Millisman/Quectel-BG95-LPWA-Module/README.md

# Quectel-BG95-LPWA-Module
Quectel BG95 LPWA Module board with integrated GPS &amp; GSM

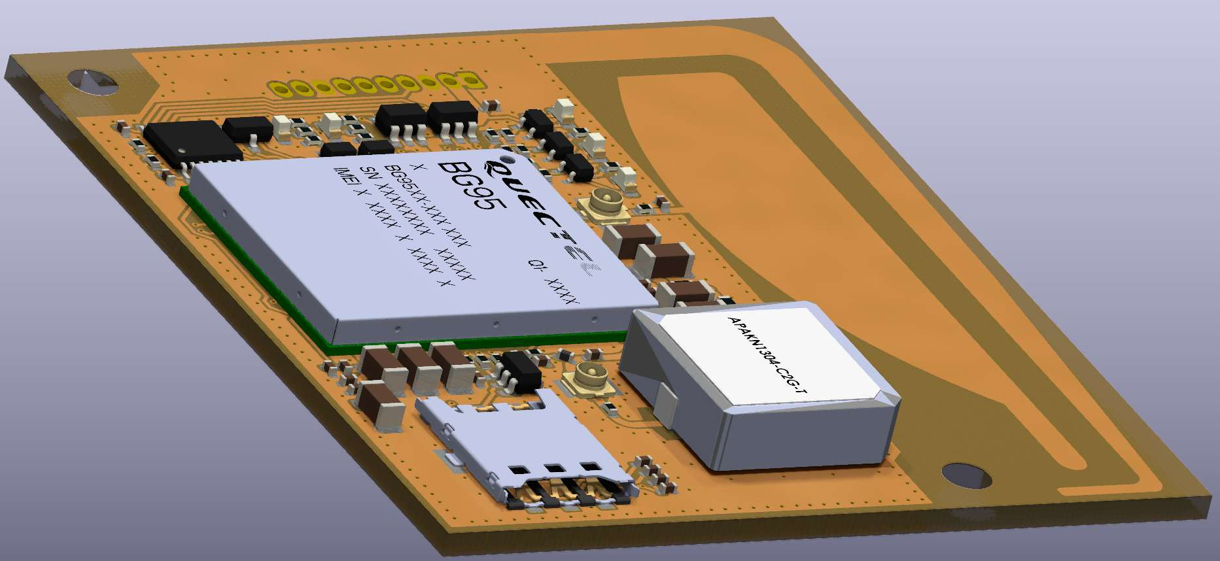
[picture p1: images/3d.jpg]
