Millisman/Quectel-BG95-LPWA-Module/images/3d.png

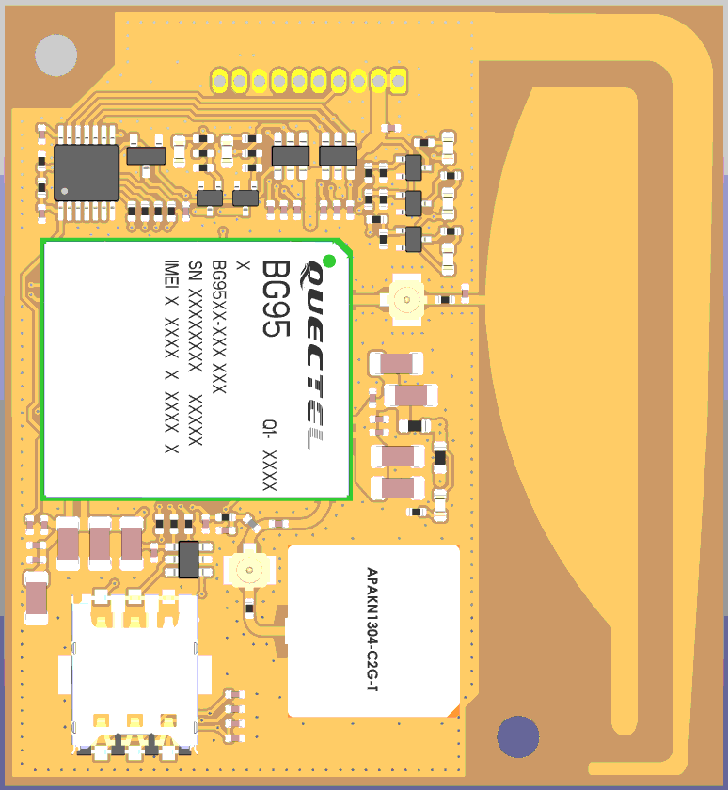
images/3d.png
