Millisman/Quectel-BG95-LPWA-Module/images/b.png

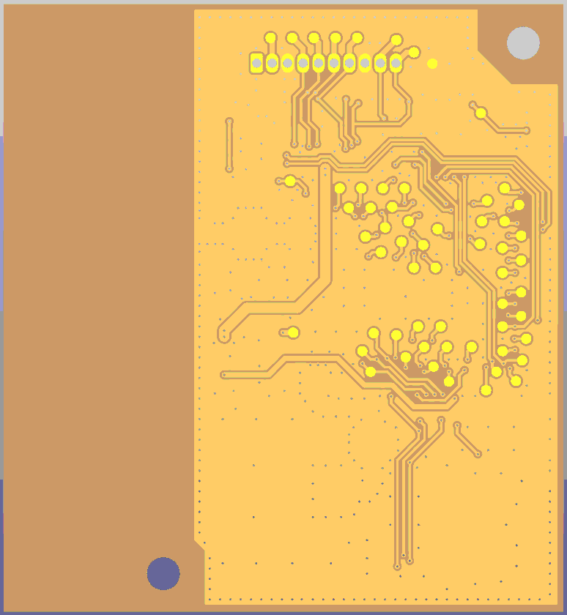
images/b.png
