Millisman/Quectel-BG95-LPWA-Module/images/t.png

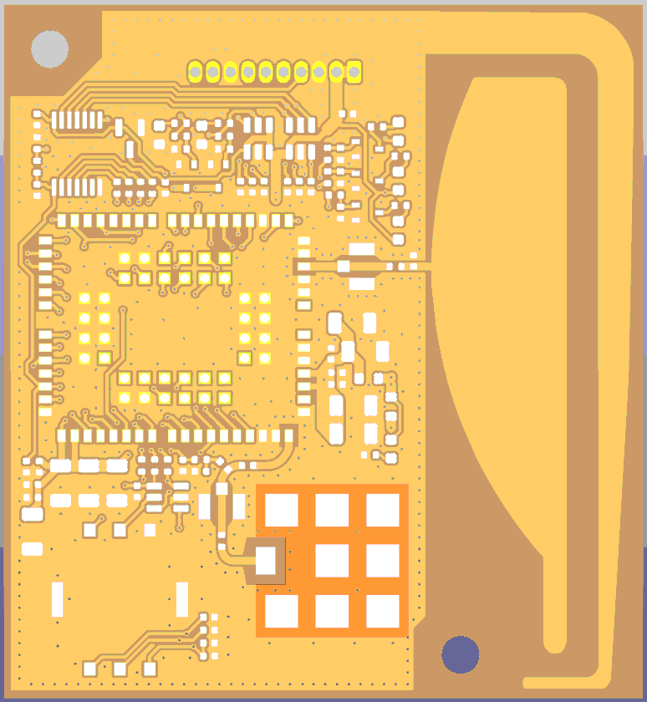
images/t.png
