Millisman/Quectel-BG95-LPWA-Module/schematic.pdf

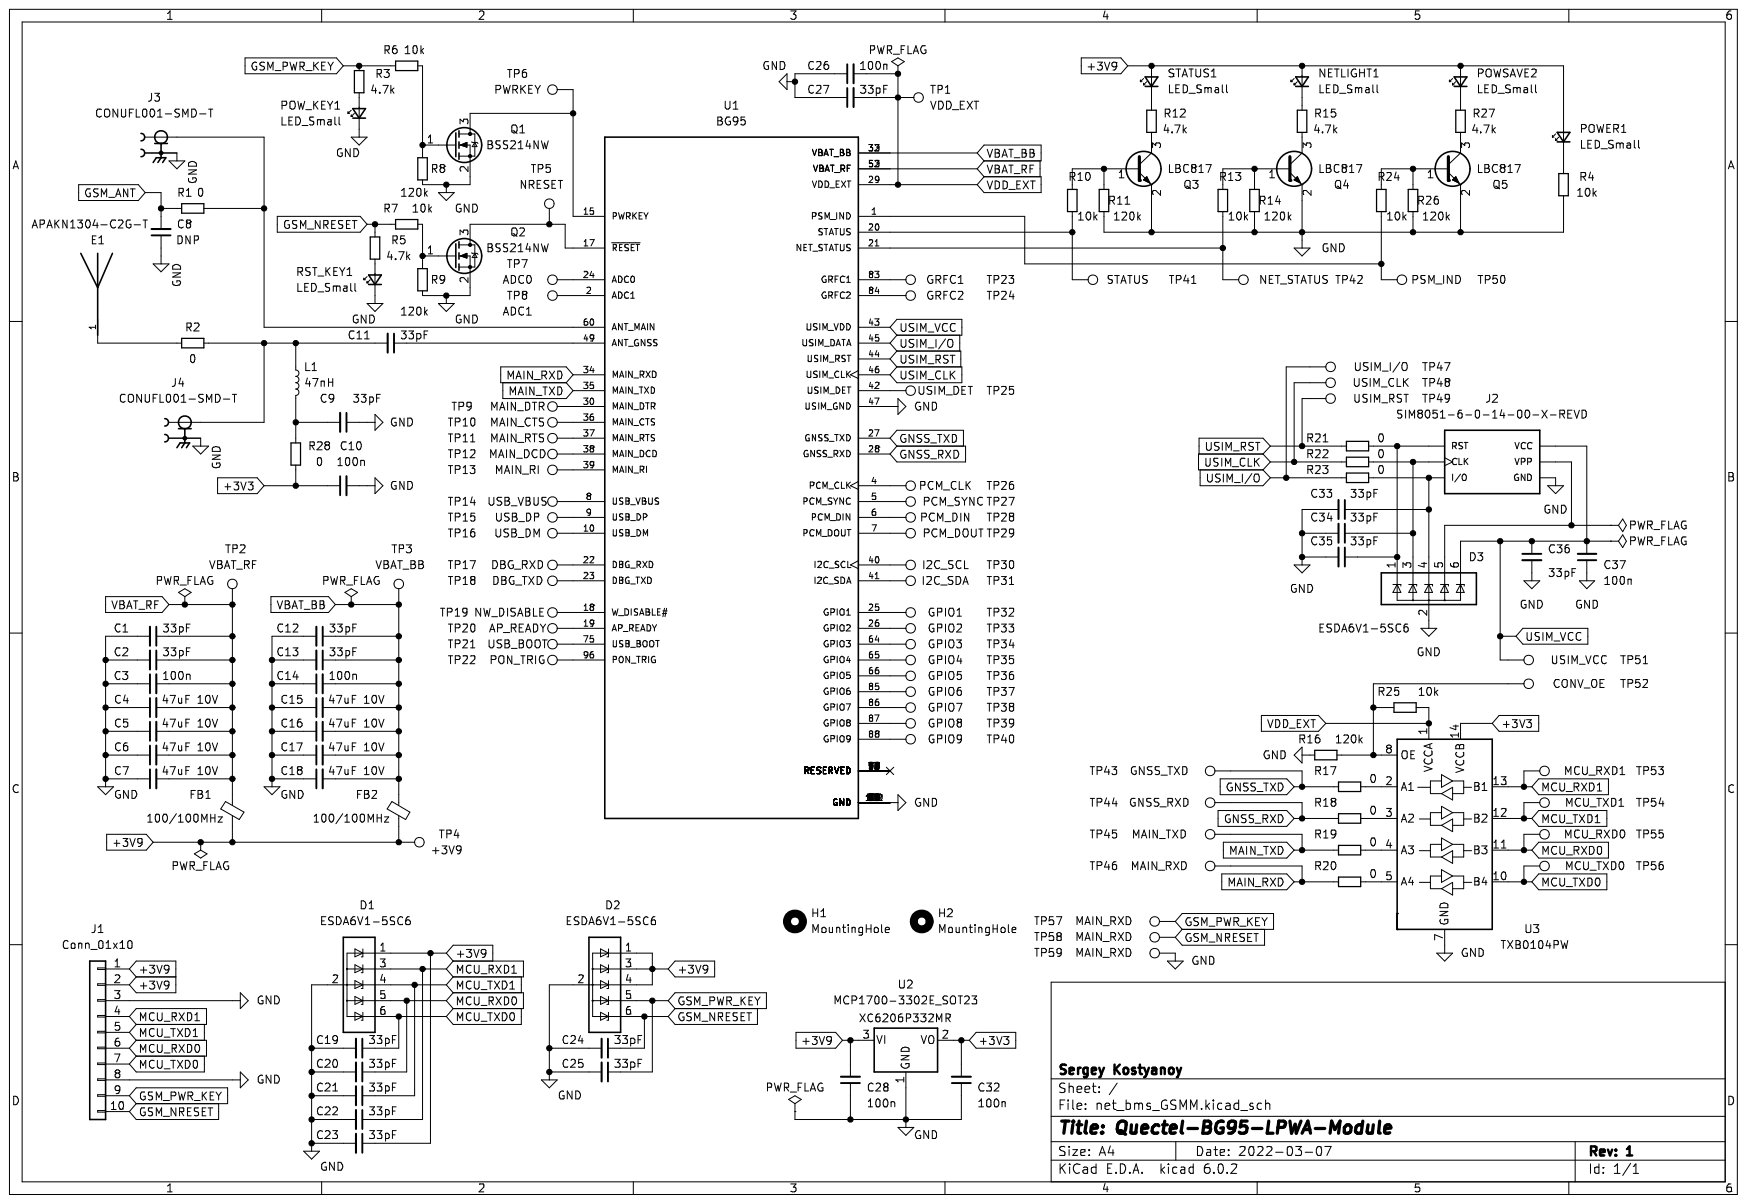
[picture p5: page 1]
