Millisman/Quectel-BG95-LPWA-Module/net_bms_GSMM.kicad_pcb

## KiCad design net_bms_GSMM.kicad_pcb (2022-03-07)

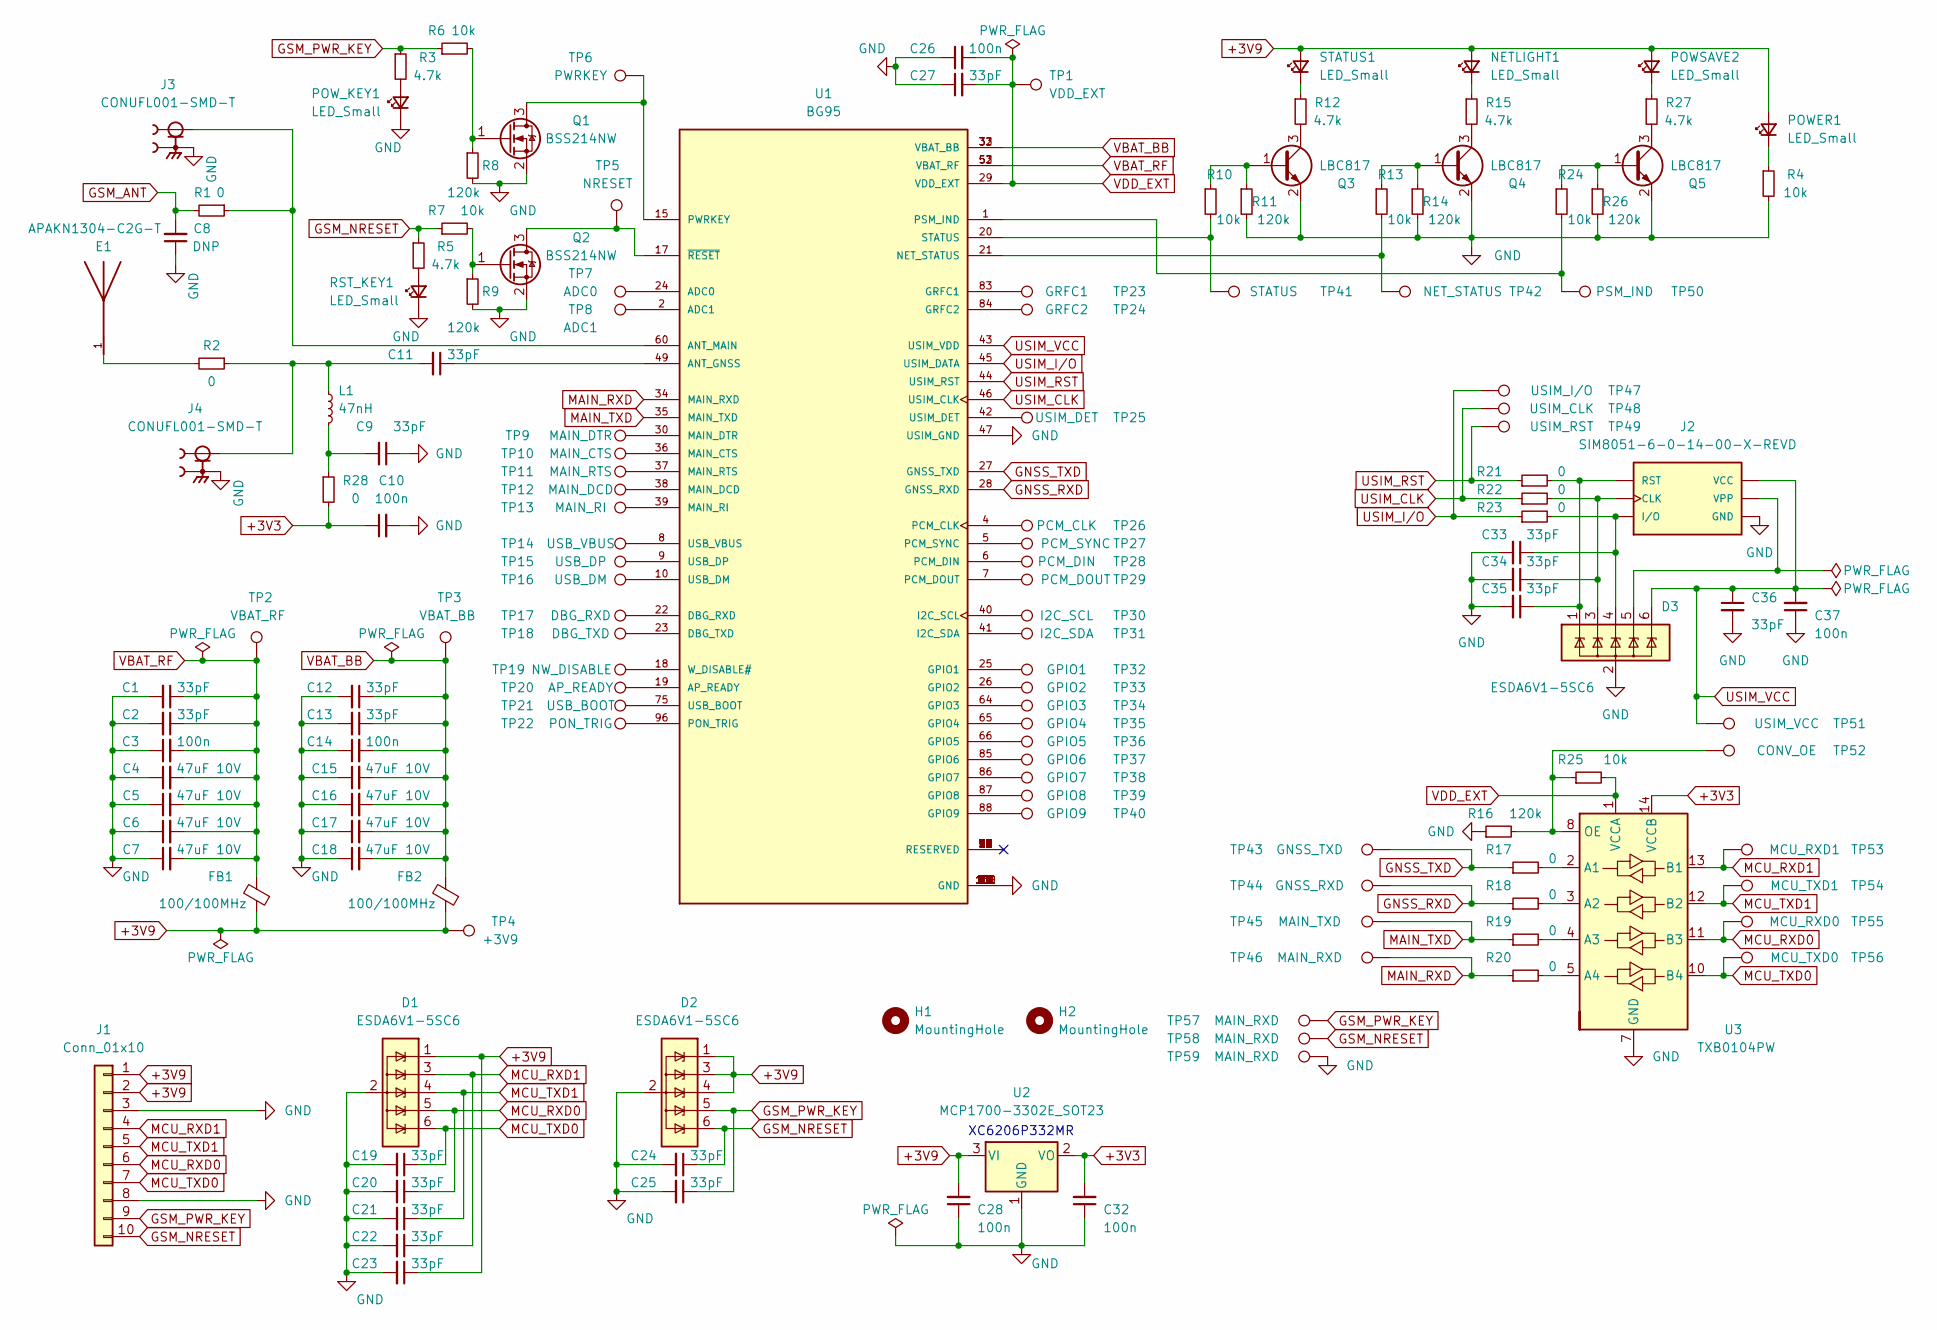
[picture p6: schematic net_bms_GSMM.kicad_sch, Quectel-BG95-LPWA-Module]

Parts:
C1, C2, C9, C11, C12, C13, C19, C20, C21, C22, C23, C24, C25, C27, C33, C34, C35, C36: 33pF; C_0402_1005Metric
C3, C10, C14, C26, C28, C32, C37: 100n; C_0402_1005Metric
C4, C5, C6, C7, C15, C16, C17, C18: 47uF 10V; C_1206_3216Metric
C8: DNP; C_0402_1005Metric
D1, D2, D3: ESDA6V1-5SC6; SOT-23-6
E1: APAKN1304-C2G-T; XCVR_APAKN1304-C2G-T; PARTREV 02.13.2020
FB1, FB2: 100/100MHz; R_0603_1608Metric
H1, H2: MountingHole; MountingHole_3.2mm_M3
J1: Conn_01x10; Wuerth_WR-WTB_64801011622_1x10_P1.50mm_Vertical
J2: SIM8051-6-0-14-00-X-REVD; GCT_SIM8051-6-0-14-00-X-REVD
J3, J4: CONUFL001-SMD-T; LINX_CONUFL001-SMD-T; PARTREV B
L1: 47nH; L_0402_1005Metric; LCSC C275325
NETLIGHT1: LED_Small; LED_0603_1608Metric
POWER1: LED_Small; LED_0603_1608Metric
POWSAVE2: LED_Small; LED_0603_1608Metric
POW_KEY1: LED_Small; LED_0603_1608Metric
Q1, Q2: BSS214NW; SOT-323_SC-70
Q3, Q4, Q5: LBC817; SOT-323_SC-70
R1, R2, R17, R18, R19, R20, R21, R22, R23, R28: 0; R_0402_1005Metric
R3, R5, R12, R15, R27: 4.7k; R_0402_1005Metric
R4, R6, R7, R10, R13, R24, R25: 10k; R_0402_1005Metric
R8, R9, R11, R14, R16, R26: 120k; R_0402_1005Metric
RST_KEY1: LED_Small; LED_0603_1608Metric
STATUS1: LED_Small; LED_0603_1608Metric
TP1: VDD_EXT; TestPoint_Pad_D1.0mm
TP2: VBAT_RF; TestPoint_Pad_D1.0mm
TP3: VBAT_BB; TestPoint_Pad_D1.0mm
TP4: +3V9; TestPoint_Pad_D1.0mm
TP5: NRESET; TestPoint_Pad_D1.0mm
TP6: PWRKEY; TestPoint_Pad_D1.0mm
TP7: ADC0; TestPoint_Pad_D1.0mm
TP8: ADC1; TestPoint_Pad_D1.0mm
TP9: MAIN_DTR; TestPoint_Pad_D1.0mm
TP10: MAIN_CTS; TestPoint_Pad_D1.0mm
TP11: MAIN_RTS; TestPoint_Pad_D1.0mm
TP12: MAIN_DCD; TestPoint_Pad_D1.0mm
TP13: MAIN_RI; TestPoint_Pad_D1.0mm
TP14: USB_VBUS; TestPoint_Pad_D1.0mm
TP15: USB_DP; TestPoint_Pad_D1.0mm
TP16: USB_DM; TestPoint_Pad_D1.0mm
TP17: DBG_RXD; TestPoint_Pad_D1.0mm
TP18: DBG_TXD; TestPoint_Pad_D1.0mm
TP19: NW_DISABLE; TestPoint_Pad_D1.0mm
TP20: AP_READY; TestPoint_Pad_D1.0mm
TP21: USB_BOOT; TestPoint_Pad_D1.0mm
TP22: PON_TRIG; TestPoint_Pad_D1.0mm
TP23: GRFC1; TestPoint_Pad_D1.0mm
TP24: GRFC2; TestPoint_Pad_D1.0mm
TP25: USIM_DET; TestPoint_Pad_D1.0mm
TP26: PCM_CLK; TestPoint_Pad_D1.0mm
TP27: PCM_SYNC; TestPoint_Pad_D1.0mm
TP28: PCM_DIN; TestPoint_Pad_D1.0mm
TP29: PCM_DOUT; TestPoint_Pad_D1.0mm
TP30: I2C_SCL; TestPoint_Pad_D1.0mm
TP31: I2C_SDA; TestPoint_Pad_D1.0mm
TP32: GPIO1; TestPoint_Pad_D1.0mm
TP33: GPIO2; TestPoint_Pad_D1.0mm
TP34: GPIO3; TestPoint_Pad_D1.0mm
TP35: GPIO4; TestPoint_Pad_D1.0mm
TP36: GPIO5; TestPoint_Pad_D1.0mm
TP37: GPIO6; TestPoint_Pad_D1.0mm
TP38: GPIO7; TestPoint_Pad_D1.0mm
TP39: GPIO8; TestPoint_Pad_D1.0mm
TP40: GPIO9; TestPoint_Pad_D1.0mm
TP41: STATUS; TestPoint_Pad_D1.0mm
TP42: NET_STATUS; TestPoint_Pad_D1.0mm
TP43: GNSS_TXD; TestPoint_Pad_D1.0mm
TP44: GNSS_RXD; TestPoint_Pad_D1.0mm
TP45: MAIN_TXD; TestPoint_Pad_D1.0mm
TP46, TP57, TP58, TP59: MAIN_RXD; TestPoint_Pad_D1.0mm
TP47: USIM_I/O; TestPoint_Pad_D1.0mm
TP48: USIM_CLK; TestPoint_Pad_D1.0mm
TP49: USIM_RST; TestPoint_Pad_D1.0mm
TP50: PSM_IND; TestPoint_Pad_D1.0mm
TP51: USIM_VCC; TestPoint_Pad_D1.0mm
TP52: CONV_OE; TestPoint_Pad_D1.0mm
TP53: MCU_RXD1; TestPoint_Pad_D1.0mm
TP54: MCU_TXD1; TestPoint_Pad_D1.0mm
TP55: MCU_RXD0; TestPoint_Pad_D1.0mm
TP56: MCU_TXD0; TestPoint_Pad_D1.0mm
U1: BG95; XCVR_BG95; PARTREV 1.1
U2: MCP1700-3302E_SOT23; SOT-23
U3: TXB0104PW; TSSOP-14_4.4x5mm_P0.65mm

Connections:
+3V3: C10.1, C32.2, R28.2, U2.2 (VO), U3.14 (VCCB)
+3V9: C23.1, C28.2, D1.1 (IO1), D2.1 (IO1), D2.3 (IO2), D2.4 (IO3), FB1.1, FB2.1, J1.1, J1.2, NETLIGHT1.2 (A), POWER1.2 (A), POWSAVE2.2 (A), STATUS1.2 (A), TP4.1, U2.3 (VI)
GND: C1.2, C2.2, C3.1, C4.1, C5.1, C6.1, C7.1, C8.1, C9.1, C10.2, C12.2, C13.2, C14.1, C15.1, C16.1, C17.1, C18.1, C19.2, C20.2, C21.2, C22.2, C23.2, C24.2, C25.2, C26.1, C27.1, C28.1, C32.1, C33.2, C34.2, C35.2, C36.2, C37.1, D1.2 (GND), D2.2 (GND), D3.2 (GND), E1.2, E1.3, E1.4, E1.5, E1.6, E1.7, E1.8, E1.9, J1.3, J1.8, J2.C4, J2.C5 (GND), J2.C8, J3.2, J3.3, J4.2, J4.3, POW_KEY1.1 (K), Q1.2 (S), Q2.2 (S), Q3.2 (E), Q4.2 (E), Q5.2 (E), R4.2, R8.2, R9.2, R11.2, R14.2, R16.1, R26.2, RST_KEY1.1 (K), TP59.1, U1.3 (GND), U1.31 (GND), U1.47 (USIM_GND), U1.48 (GND), U1.50 (GND), U1.54 (GND), U1.55 (GND), U1.58 (GND), U1.59 (GND), U1.61 (GND), U1.62 (GND), U1.67 (GND), U1.68 (GND), U1.69 (GND), U1.70 (GND), U1.71 (GND), U1.72 (GND), U1.73 (GND), U1.74 (GND), U1.79 (GND), U1.80 (GND), U1.81 (GND), U1.82 (GND), U1.89 (GND), U1.90 (GND), U1.91 (GND), U1.100 (GND), U1.101 (GND), U1.102 (GND), U2.1 (GND), U3.7 (GND)
GNSS_RXD: R18.1, TP44.1, U1.28 (GNSS_RXD)
GNSS_TXD: R17.1, TP43.1, U1.27 (GNSS_TXD)
GSM_ANT: C8.2, R1.2
GSM_NRESET: C24.1, D2.6 (IO5), J1.10, R5.1, R7.1, TP58.1
GSM_PWR_KEY: C25.1, D2.5 (IO4), J1.9, R3.1, R6.1, TP57.1
MAIN_RXD: R20.1, TP46.1, U1.34 (MAIN_RXD)
MAIN_TXD: R19.1, TP45.1, U1.35 (MAIN_TXD)
MCU_RXD0: C20.1, D1.5 (IO4), J1.6, TP55.1, U3.11 (B3)
MCU_RXD1: C22.1, D1.3 (IO2), J1.4, TP53.1, U3.13 (B1)
MCU_TXD0: C19.1, D1.6 (IO5), J1.7, TP56.1, U3.10 (B4)
MCU_TXD1: C21.1, D1.4 (IO3), J1.5, TP54.1, U3.12 (B2)
unnamed: C9.2, L1.2, R28.1
unnamed: C11.1, U1.49 (ANT_GNSS)
unnamed: C11.2, J4.1, L1.1, R2.1
unnamed: C33.1, D3.4 (IO3), J2.C7 (I/O), R23.2
unnamed: C34.1, D3.3 (IO2), J2.C3 (CLK), R22.2
unnamed: C35.1, D3.1 (IO1), J2.C2 (RST), R21.2
unnamed: D3.5 (IO4), J2.C6 (VPP)
unnamed: E1.1, R2.2
unnamed: J3.1, R1.1, U1.60 (ANT_MAIN)
unnamed: NETLIGHT1.1 (K), R15.1
unnamed: POWER1.1 (K), R4.1
unnamed: POWSAVE2.1 (K), R27.1
unnamed: POW_KEY1.2 (A), R3.2
unnamed: Q1.1 (G), R6.2, R8.1
unnamed: Q1.3 (D), TP6.1, U1.15 (PWRKEY)
unnamed: Q2.1 (G), R7.2, R9.1
unnamed: Q2.3 (D), TP5.1, U1.17 (~RESET)
unnamed: Q3.1 (B), R10.1, R11.1
unnamed: Q3.3 (C), R12.2
unnamed: Q4.1 (B), R13.1, R14.1
unnamed: Q4.3 (C), R15.2
unnamed: Q5.1 (B), R24.1, R26.1
unnamed: Q5.3 (C), R27.2
unnamed: R5.2, RST_KEY1.2 (A)
unnamed: R10.2, TP41.1, U1.20 (STATUS)
unnamed: R12.1, STATUS1.1 (K)
unnamed: R13.2, TP42.1, U1.21 (NET_STATUS)
unnamed: R16.2, R25.1, TP52.1, U3.8 (OE)
unnamed: R17.2, U3.2 (A1)
unnamed: R18.2, U3.3 (A2)
unnamed: R19.2, U3.4 (A3)
unnamed: R20.2, U3.5 (A4)
unnamed: R24.2, TP50.1, U1.1 (PSM_IND)
unnamed: TP7.1, U1.24 (ADC0)
unnamed: TP8.1, U1.2 (ADC1)
unnamed: TP9.1, U1.30 (MAIN_DTR)
unnamed: TP10.1, U1.36 (MAIN_CTS)
unnamed: TP11.1, U1.37 (MAIN_RTS)
unnamed: TP12.1, U1.38 (MAIN_DCD)
unnamed: TP13.1, U1.39 (MAIN_RI)
unnamed: TP14.1, U1.8 (USB_VBUS)
unnamed: TP15.1, U1.9 (USB_DP)
unnamed: TP16.1, U1.10 (USB_DM)
unnamed: TP17.1, U1.22 (DBG_RXD)
unnamed: TP18.1, U1.23 (DBG_TXD)
unnamed: TP19.1, U1.18 (W_DISABLE#)
unnamed: TP20.1, U1.19 (AP_READY)
unnamed: TP21.1, U1.75 (USB_BOOT)
unnamed: TP22.1, U1.96 (PON_TRIG)
unnamed: TP23.1, U1.83 (GRFC1)
unnamed: TP24.1, U1.84 (GRFC2)
unnamed: TP25.1, U1.42 (USIM_DET)
unnamed: TP26.1, U1.4 (PCM_CLK)
unnamed: TP27.1, U1.5 (PCM_SYNC)
unnamed: TP28.1, U1.6 (PCM_DIN)
unnamed: TP29.1, U1.7 (PCM_DOUT)
unnamed: TP30.1, U1.40 (I2C_SCL)
unnamed: TP31.1, U1.41 (I2C_SDA)
unnamed: TP32.1, U1.25 (GPIO1)
unnamed: TP33.1, U1.26 (GPIO2)
unnamed: TP34.1, U1.64 (GPIO3)
unnamed: TP35.1, U1.65 (GPIO4)
unnamed: TP36.1, U1.66 (GPIO5)
unnamed: TP37.1, U1.85 (GPIO6)
unnamed: TP38.1, U1.86 (GPIO7)
unnamed: TP39.1, U1.87 (GPIO8)
unnamed: TP40.1, U1.88 (GPIO9)
USIM_CLK: R22.1, TP48.1, U1.46 (USIM_CLK)
USIM_I/O: R23.1, TP47.1, U1.45 (USIM_DATA)
USIM_RST: R21.1, TP49.1, U1.44 (USIM_RST)
USIM_VCC: C36.1, C37.2, D3.6 (IO5), J2.C1 (VCC), TP51.1, U1.43 (USIM_VDD)
VBAT_BB: C12.1, C13.1, C14.2, C15.2, C16.2, C17.2, C18.2, FB2.2, TP3.1, U1.32 (VBAT_BB), U1.33 (VBAT_BB)
VBAT_RF: C1.1, C2.1, C3.2, C4.2, C5.2, C6.2, C7.2, FB1.2, TP2.1, U1.52 (VBAT_RF), U1.53 (VBAT_RF)
VDD_EXT: C26.2, C27.2, R25.2, TP1.1, U1.29 (VDD_EXT), U3.1 (VCCA)

Notes on the sheet:
XC6206P332MR

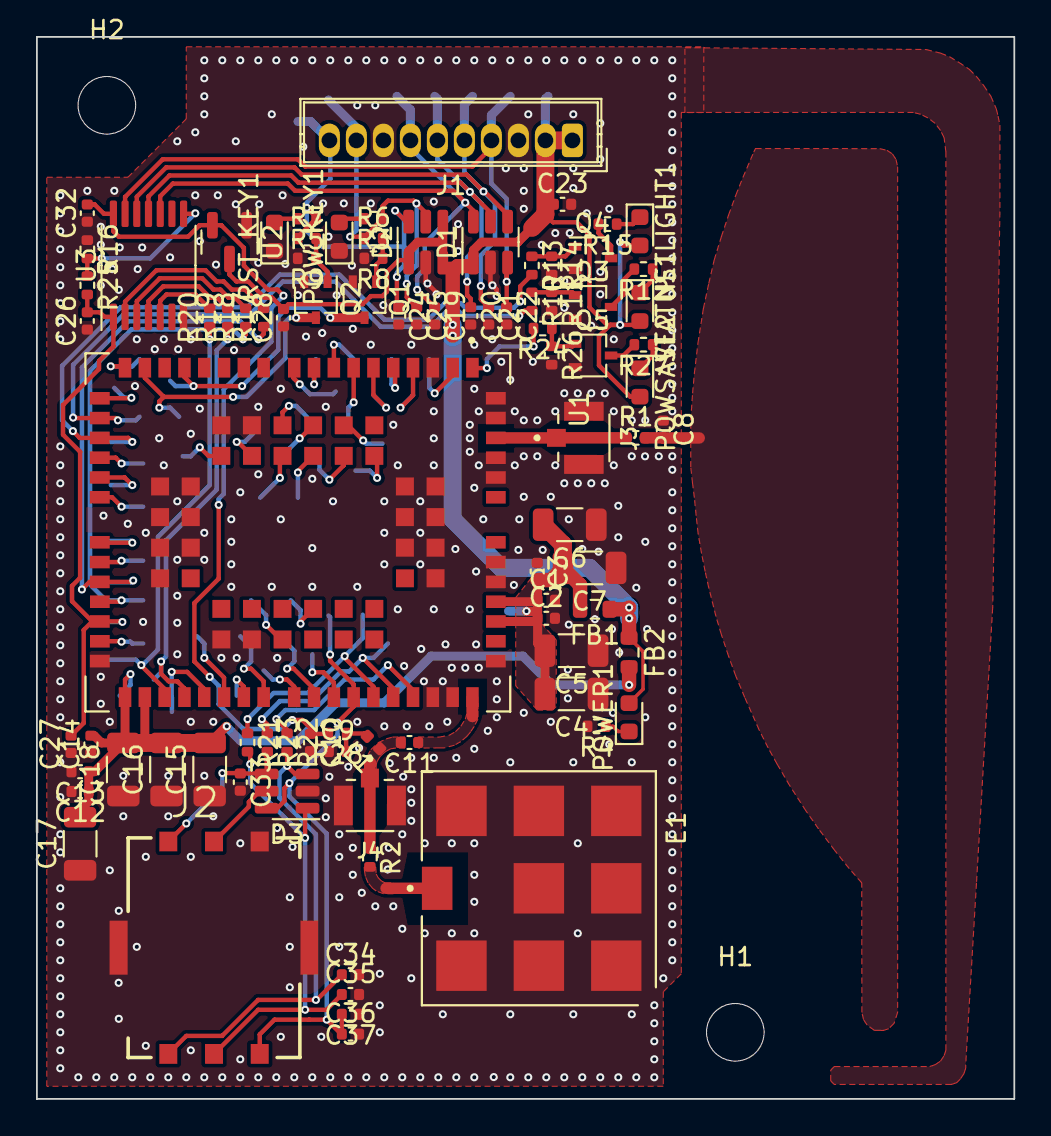
[picture p7: board net_bms_GSMM.kicad_pcb from above]

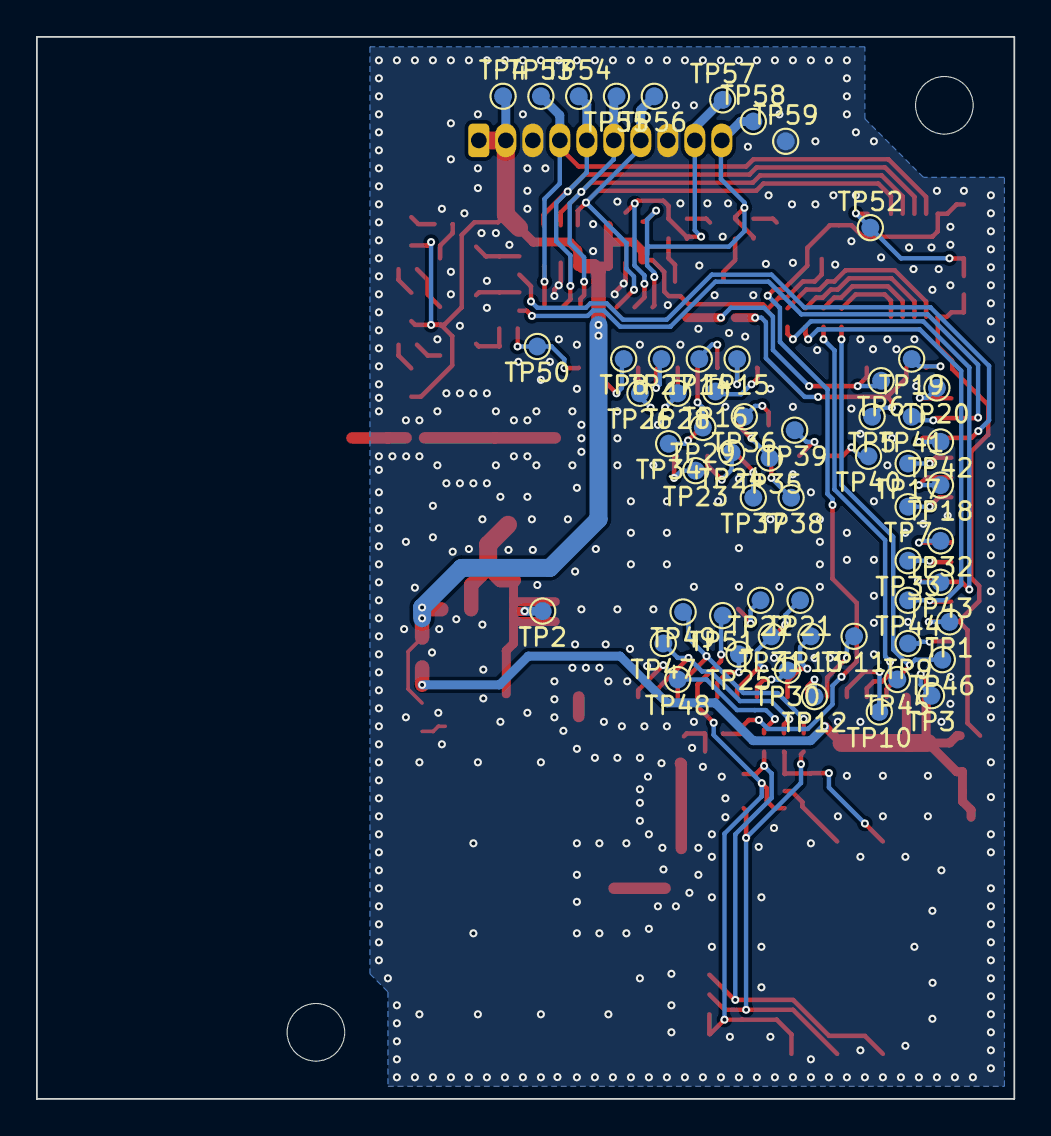
[picture p8: board net_bms_GSMM.kicad_pcb from below]

Board: 2 copper layers, 54.3 x 59.0 mm, 148 parts (59 on the bottom side), 88 nets.
